otnielxs/esp32-soil-moisture-node/docs/cover.jpg

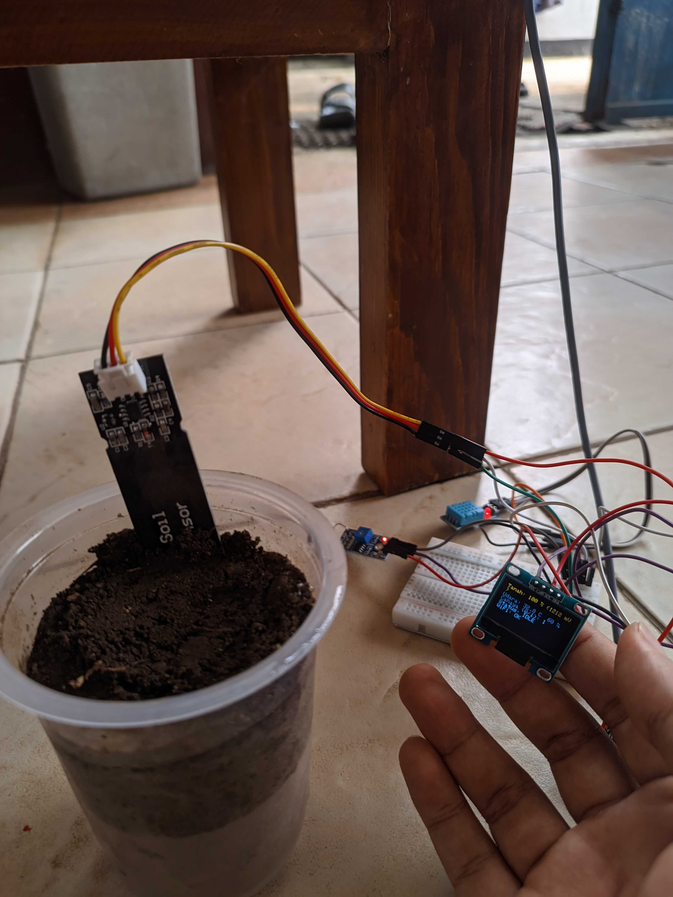
docs/cover.jpg
