otnielxs/esp32-soil-moisture-node/docs/influxdb.png

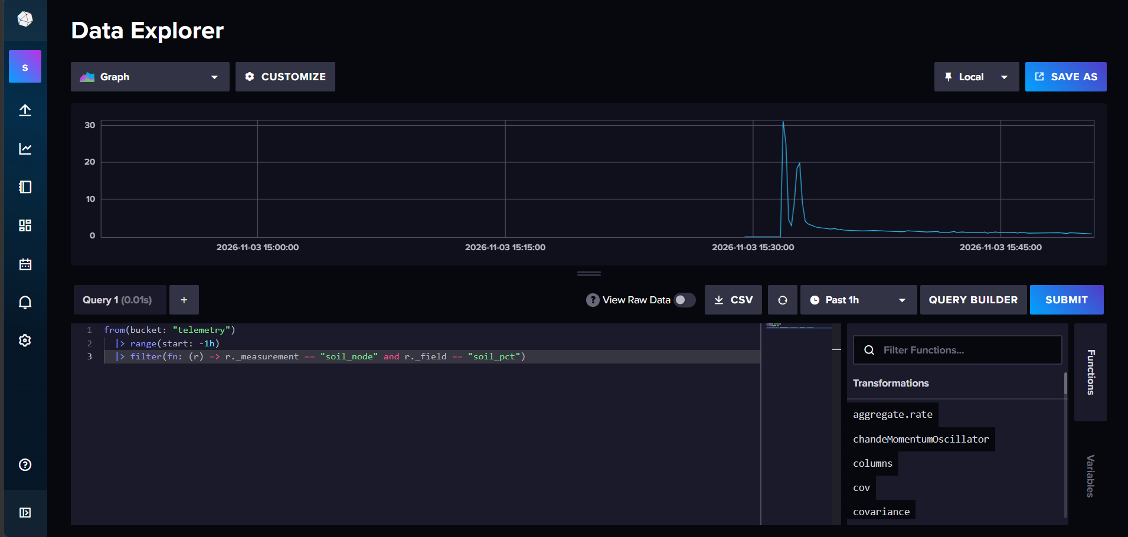
docs/influxdb.png
