otnielxs/esp32-soil-moisture-node/docs/node-red.png

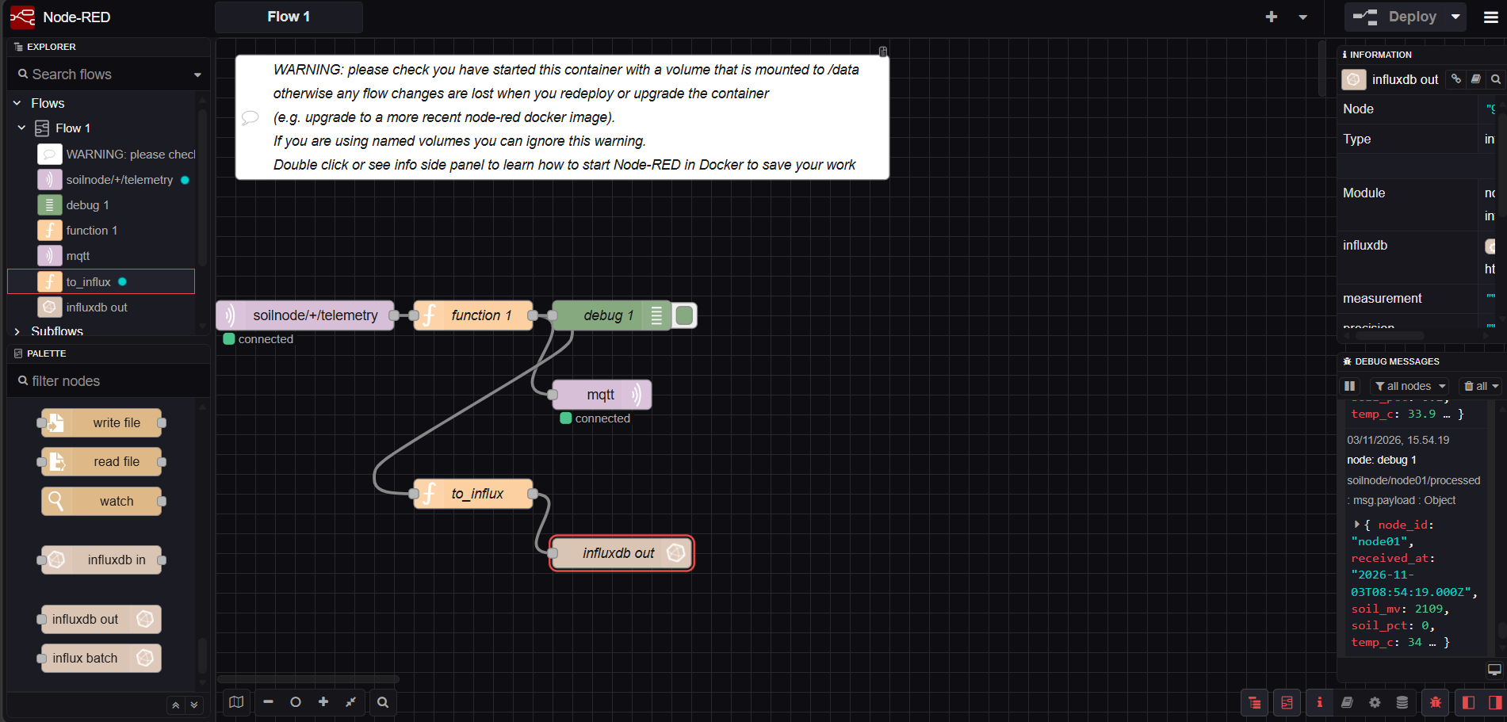
docs/node-red.png
