otnielxs/esp32-soil-moisture-node/data/calibration_points.csv

moisture_pct | file
0.0 | cal_p1.csv
10.9 | cal_p2.csv
22.3 | cal_p3.csv
43.3 | cal_p5.csv
