otnielxs/esp32-soil-moisture-node/data/calibration_summary.csv

moisture_pct | mv_mean | mv_std
0.0 | 2107.3 | 1.7495762198751283
10.9 | 1216.75 | 2.6783817527677645
22.3 | 966.0833333333334 | 6.084968049069123
32.7 | 851.35 | 309.03534025322045
43.3 | 867.1166666666667 | 5.545166368694196
