otnielxs/esp32-soil-moisture-node/docs/calibrate setup.png

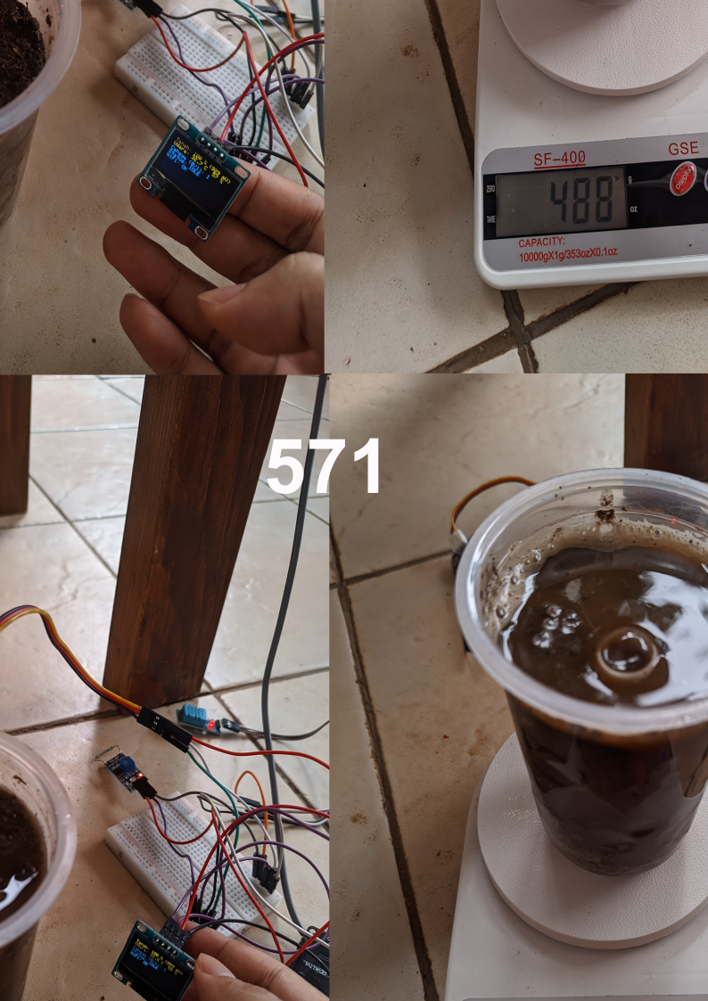
docs/calibrate setup.png
