otnielxs/esp32-soil-moisture-node/firmware/soil_node/secrets.example.h

#pragma once
#define WIFI_SSID "wifi_name"
#define WIFI_PASS "wifi_password"
#define AIO_USER  "adafruit_username"
#define AIO_KEY   "aio_key"
#define MQTT_HOST "192.168.1.100"   // IP laptop (PowerShell: ipconfig -> Wi-Fi -> IPv4)
