otnielxs/esp32-soil-moisture-node/(commit log)

2026-10-20 ESP32 soil moisture node: firmware, calibration, Adafruit IO dashboard
    [cal_p1.csv, cal_p2.csv, cal_p3.csv, cal_p4_rejected.csv, cal_p5.csv, calibration_points.csv, calibration_summary.csv]
2026-10-20 Update calibration and trace documentation images
2026-11-03 Add Node-RED: MQTT subscriber, validation and enrichment flow
2026-11-03 Add InfluxDB storage: compose service, .env.example, Node-RED write flow
